tiltit/or-clock/hardware/or-clock_display/or-clock_display.pdf

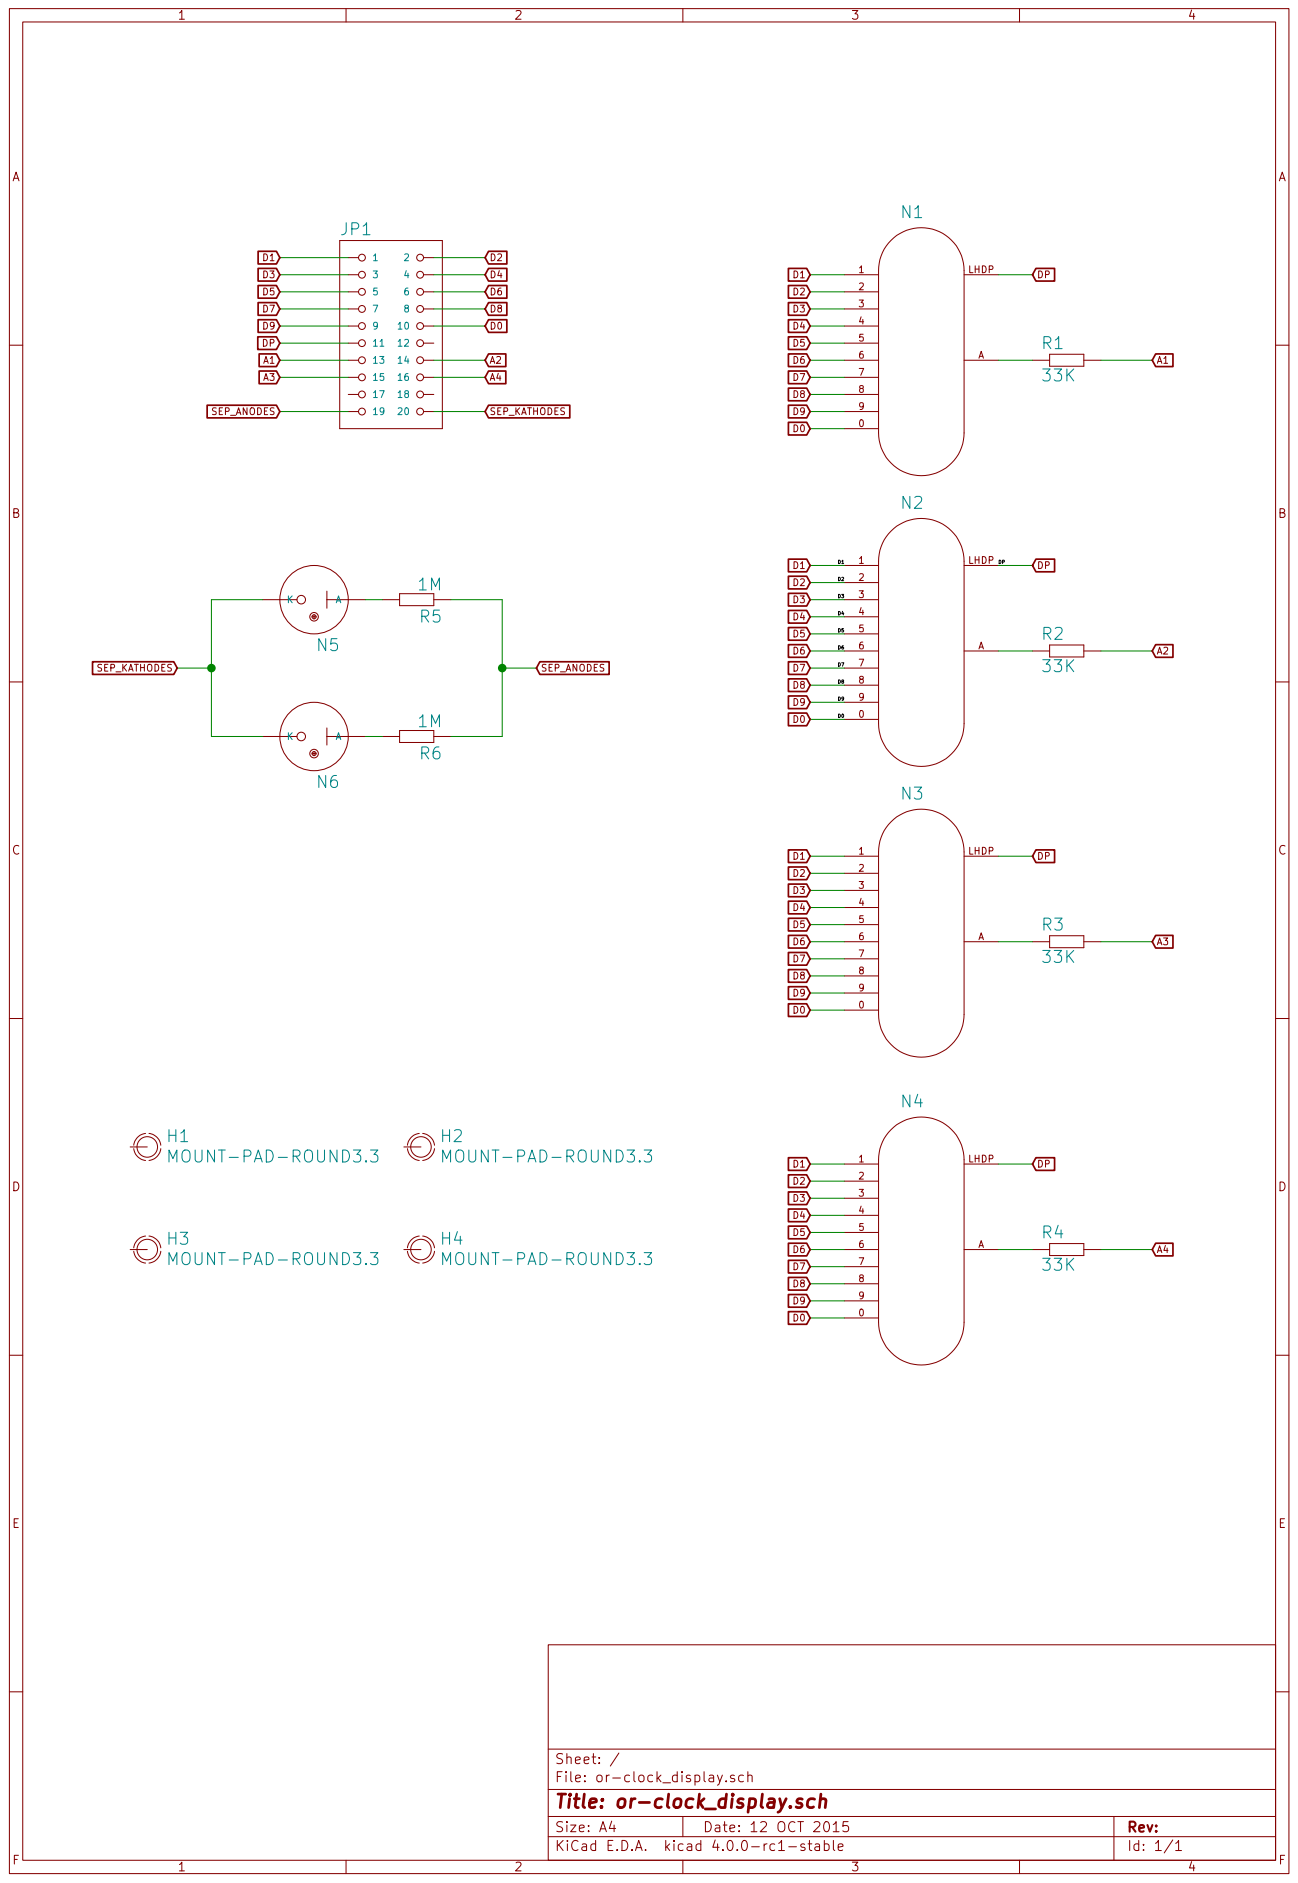
[picture p1: page 1]

File: or-clock_display.sch Sheet: / H1
MOUNT-PAD-ROUND3.3

Id: 1/1 Title: or-clock_display.sch
