tiltit/or-clock/hardware/or-clock_interconnect/or-clock_interconnect.pdf

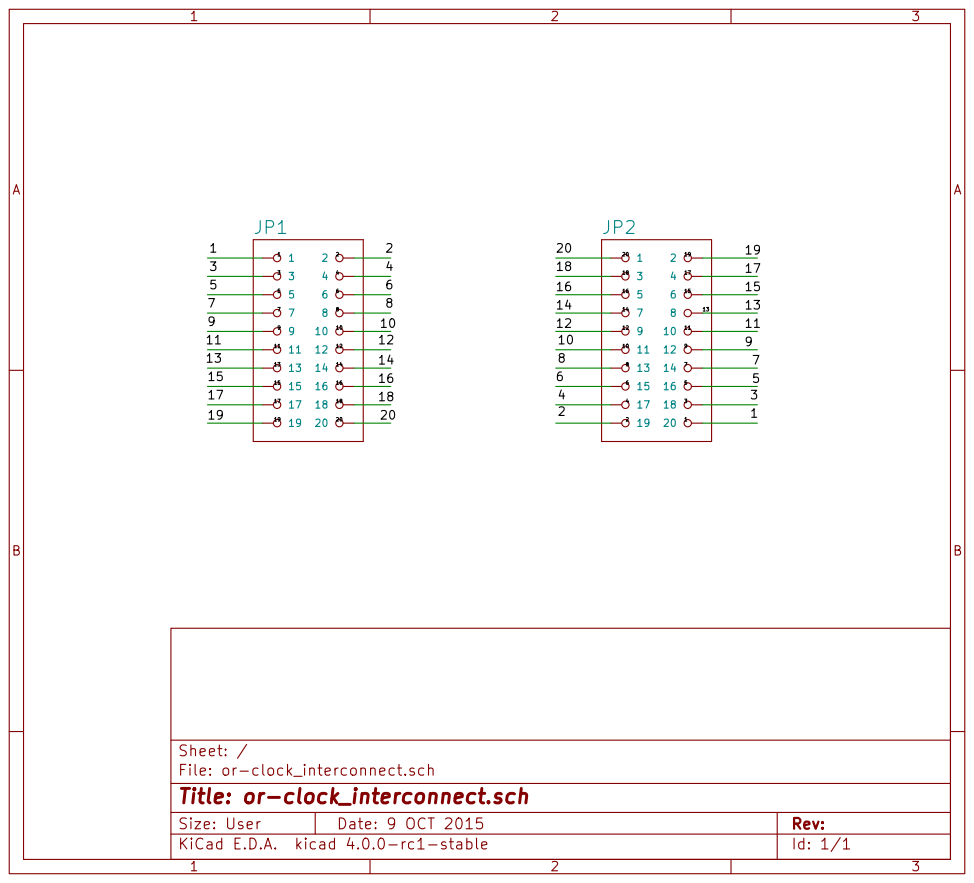
[picture p2: page 1]

File: or-clock_interconnect.sch Sheet: /
Id: 1/1 Title: or-clock_interconnect.sch
