tiltit/or-clock/hardware/or-clock_mainboard/or-clock_mainboard.pdf

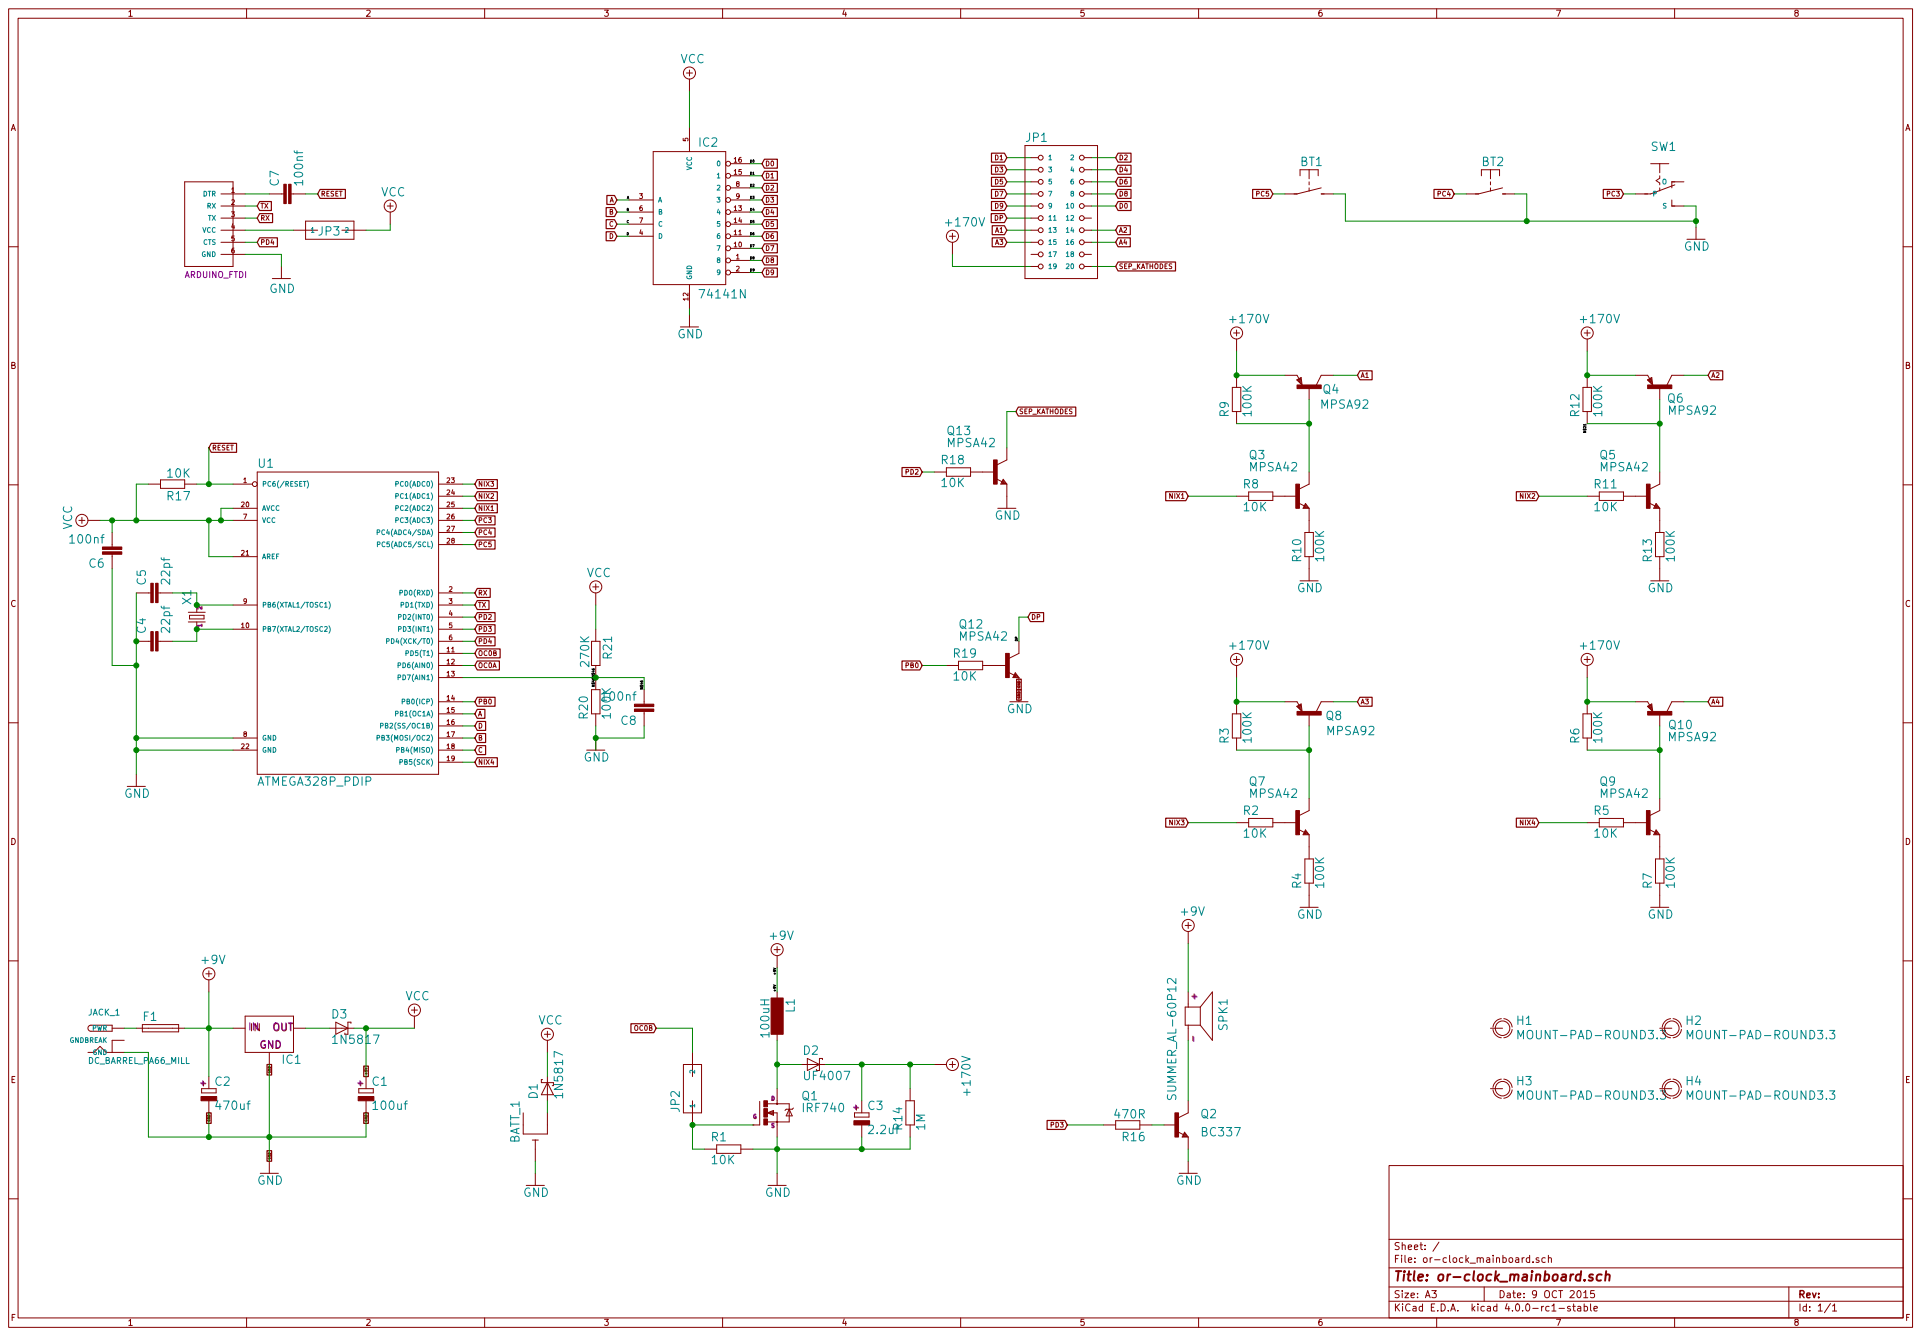
[picture p3: page 1]

File: or-clock_mainboard.sch Sheet: / BATT_1

Id: 1/1 Title: or-clock_mainboard.sch
