tiltit/or-clock/hardware/or-clock_display/or-clock_display.kicad_pcb

## KiCad design hardware/or-clock_display/or-clock_display.kicad_pcb (2015-10-25)

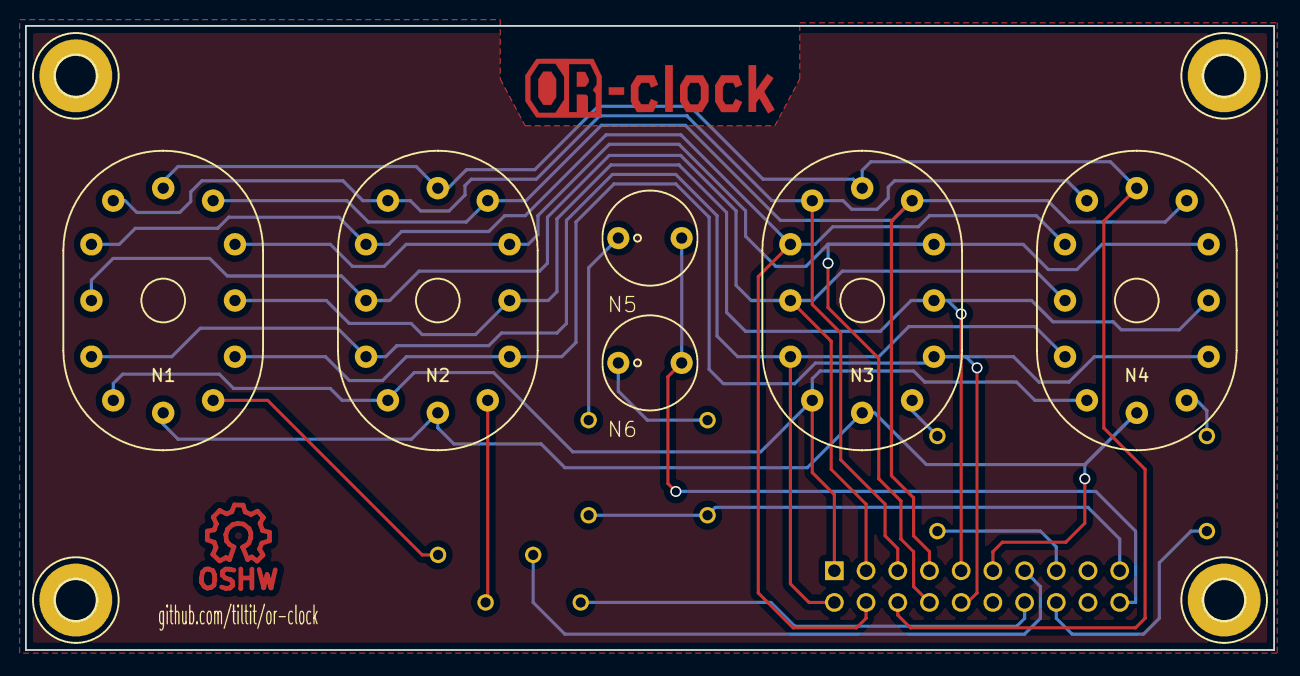
[picture p4: board or-clock_display.kicad_pcb from above]

Board: 2 copper layers, 100.0 x 50.0 mm, 17 parts (0 on the bottom side), 23 nets.

Parts:
H1, H2, H3, H4: MOUNT-PAD-ROUND3.3; 3,3-PAD
JP1: 2X10
N1, N2, N3, N4: IN-12B; in-12
N5, N6: INS-1
R1, R2, R3, R4: 33K; 0207%2f7
R5, R6: 1M; 0207%2f7

Connections:
/A1: JP1.13, R1.2
/A2: JP1.14, R2.2
/A3: JP1.15, R3.2
/A4: JP1.16, R4.2
/D0: JP1.10, N1.0, N2.0, N3.0, N4.0
/D1: JP1.1, N1.1, N2.1, N3.1, N4.1
/D2: JP1.2, N1.2, N2.2, N3.2, N4.2
/D3: JP1.3, N1.3, N2.3, N3.3, N4.3
/D4: JP1.4, N1.4, N2.4, N3.4, N4.4
/D5: JP1.5, N1.5, N2.5, N3.5, N4.5
/D6: JP1.6, N1.6, N2.6, N3.6, N4.6
/D7: JP1.7, N1.7, N2.7, N3.7, N4.7
/D8: JP1.8, N1.8, N2.8, N3.8, N4.8
/D9: JP1.9, N1.9, N2.9, N3.9, N4.9
/DP: JP1.11, N1.LHDP, N2.LHDP, N3.LHDP, N4.LHDP
/N$1: N1.A, R1.1
/N$2: N2.A, R2.1
/N$3: N3.A, R3.1
/N$4: N4.A, R4.1
/N$5: N5.A, R5.2
/N$6: N6.A, R6.2
/SEP_ANODES: JP1.19, R5.1, R6.1
/SEP_KATHODES: JP1.20, N5.K, N6.K
