tiltit/or-clock/hardware/or-clock_mainboard/or-clock_mainboard.kicad_pcb

## KiCad design hardware/or-clock_mainboard/or-clock_mainboard.kicad_pcb (2015-10-25)

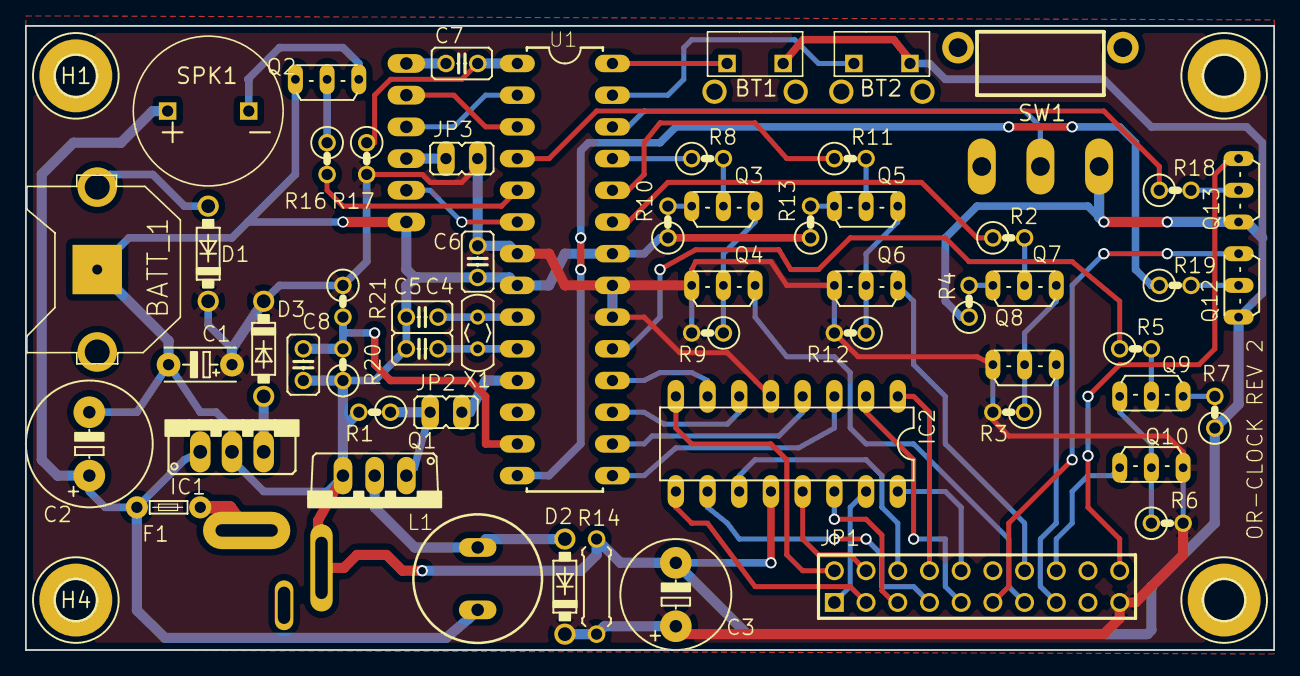
[picture p5: board or-clock_mainboard.kicad_pcb from above]

Board: 2 copper layers, 100.0 x 50.0 mm, 63 parts (0 on the bottom side), 64 nets.

Parts:
BATT_1: CR1220-THM
BT1, BT2: BUT3305D
C1: 100uf; E5-6
C2: 470uf; E5-10,5
C3: 2.2uf; E5-8,5
C4, C5: 22pf; C025-025X050
C6, C7, C8: 100nf; C025-025X050
D1, D3: 1N5817; DO41-7.6
D2: UF4007; DO41-7.6
F1: LITTLEFUSE
H1, H2, H3, H4: MOUNT-PAD-ROUND3.3; 3,3-PAD
IC1: 78XXS
IC2: 74141N; DIL16
JACK_1: DC_BARREL_PA66_MILL; PA66_DC_JACK_MILL
JP1: 2X10
JP2, JP3: JP1
L1: 100uH; BS11
Q1: IRF740; TO220BV
Q2: BC337; TO92-
Q3, Q5, Q7, Q9, Q12, Q13: MPSA42; TO92-
Q4, Q6, Q8, Q10: MPSA92; TO92-
R1, R2, R5, R8, R11, R17, R18, R19: 10K; 0207%2f2V
R3, R4, R6, R7, R9, R10, R12, R13, R20: 100K; 0207%2f2V
R14: 1M; 0207%2f7
R16: 470R; 0207%2f2V
R21: 270K; 0207%2f2V
SERIAL_CON22: ARDUINO_FTDI_HEADERV; 1X06
SPK1: SUMMER_AL-60P12; AL-60P12_SUMMER
SW1: TS-13P
U1: ATMEGA328P_PDIP; DIL28-3
X1: TC26V

Connections:
+5V: C1.+, C3.+, C6.2, D1.C, D2.C, D3.C, IC2.5, JP1.19, JP3.2, Q4.3, Q6.3, Q8.3, Q10.3, R3.2, R6.2, R9.2, R12.2, R14.2, R17.2, R21.1, U1.7, U1.20, U1.21
+9V: C2.+, F1.2, IC1.IN, L1.1, SPK1.POS
/N$21: Q5.1, Q6.2, R12.1
/N$46: C8.2, R20.2, R21.2, U1.13
A: IC2.3, U1.15
A1: JP1.13, Q4.1
A2: JP1.14, Q6.1
A3: JP1.15, Q8.1
A4: JP1.16, Q10.1
B: IC2.6, U1.17
C: IC2.7, U1.18
D: IC2.4, U1.16
D0: IC2.16, JP1.10
D1: IC2.15, JP1.1
D2: IC2.8, JP1.2
D3: IC2.9, JP1.3
D4: IC2.13, JP1.4
D5: IC2.14, JP1.5
D6: IC2.11, JP1.6
D7: IC2.10, JP1.7
D8: IC2.1, JP1.8
D9: IC2.2, JP1.9
DP: JP1.11, Q12.1
GND: BATT_1.-, BT1.P$2, BT2.P$2, C1.-, C2.-, C3.-, C4.1, C5.1, C6.1, C8.1, IC1.GND, IC2.12, JACK_1.V-, Q1.S, Q2.3, Q12.3, Q13.3, R1.2, R4.1, R7.1, R10.1, R13.1, R14.1, R20.1, SERIAL_CON22.6, SW1.PIN3, U1.8, U1.22
NIX1: R8.1, U1.25
NIX2: R11.1, U1.24
NIX3: R2.1, U1.23
NIX4: R5.1, U1.19
unnamed: BATT_1.+2, D1.A
unnamed: C4.2, U1.10, X1.1
unnamed: C5.2, U1.9, X1.2
unnamed: C7.1, SERIAL_CON22.1
unnamed: D2.A, L1.2, Q1.D
unnamed: D3.A, IC1.OUT
unnamed: F1.1, JACK_1.V+
unnamed: JP2.1, Q1.G, R1.1
unnamed: JP3.1, SERIAL_CON22.4
unnamed: Q2.1, SPK1.NEG
unnamed: Q2.2, R16.1
unnamed: Q3.1, Q4.2, R9.1
unnamed: Q3.2, R8.2
unnamed: Q3.3, R10.2
unnamed: Q5.2, R11.2
unnamed: Q5.3, R13.2
unnamed: Q7.1, Q8.2, R3.1
unnamed: Q7.2, R2.2
unnamed: Q7.3, R4.2
unnamed: Q9.2, R5.2
unnamed: Q9.3, R7.2
unnamed: Q9.1, Q10.2, R6.1
unnamed: Q12.2, R19.2
unnamed: Q13.2, R18.2
OC0B: JP2.2, U1.11
PB0: R19.1, U1.14
PC3: SW1.PIN2, U1.26
PC4: BT2.P$1, U1.27
PC5: BT1.P$1, U1.28
PD2: R18.1, U1.4
PD3: R16.2, U1.5
PD4: SERIAL_CON22.5, U1.6
RESET: C7.2, R17.1, U1.1
RX: SERIAL_CON22.3, U1.2
SEP_KATHODES: JP1.20, Q13.1
TX: SERIAL_CON22.2, U1.3
