tiltit/or-clock/(commit log)

2015-05-22 rock on
    [or-clock_display.brd, or-clock_display.sch, or-clock_interconnect.brd, or-clock_interconnect.sch, or-clock_main.brd, or-clock_main.sch]
2015-10-25 removed old eagle files
    [or-clock_display.brd, or-clock_display.sch, or-clock_interconnect.brd, or-clock_interconnect.sch, or-clock_main.brd, or-clock_main.sch]
2015-10-25 Added new Kicad files
    [or-clock_display.kicad_pcb, or-clock_display.sch, or-clock_interconnect.kicad_pcb, or-clock_interconnect.sch, or-clock_mainboard.kicad_pcb, or-clock_mainboard.sch]
